PhysicsUofRAUI/Decorations/tlc555cp_christmas/tree.png

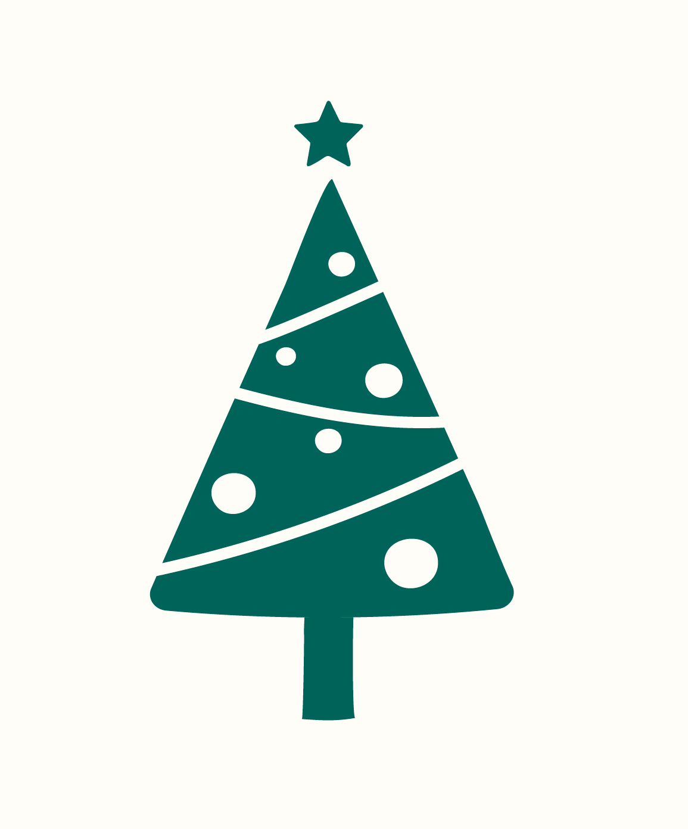
tlc555cp_christmas/tree.png
