PhysicsUofRAUI/Decorations/tlc555cp_easter/easter_egg_pic.jpg

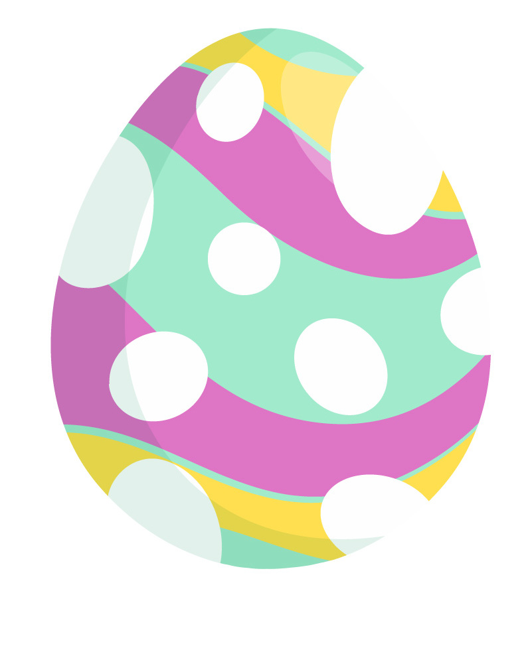
tlc555cp_easter/easter_egg_pic.jpg
