PhysicsUofRAUI/Decorations/tlc555cp_easter/tlc555cp_easter.kicad_pcb

## KiCad design tlc555cp_easter/tlc555cp_easter.kicad_pcb (2023-01-28)

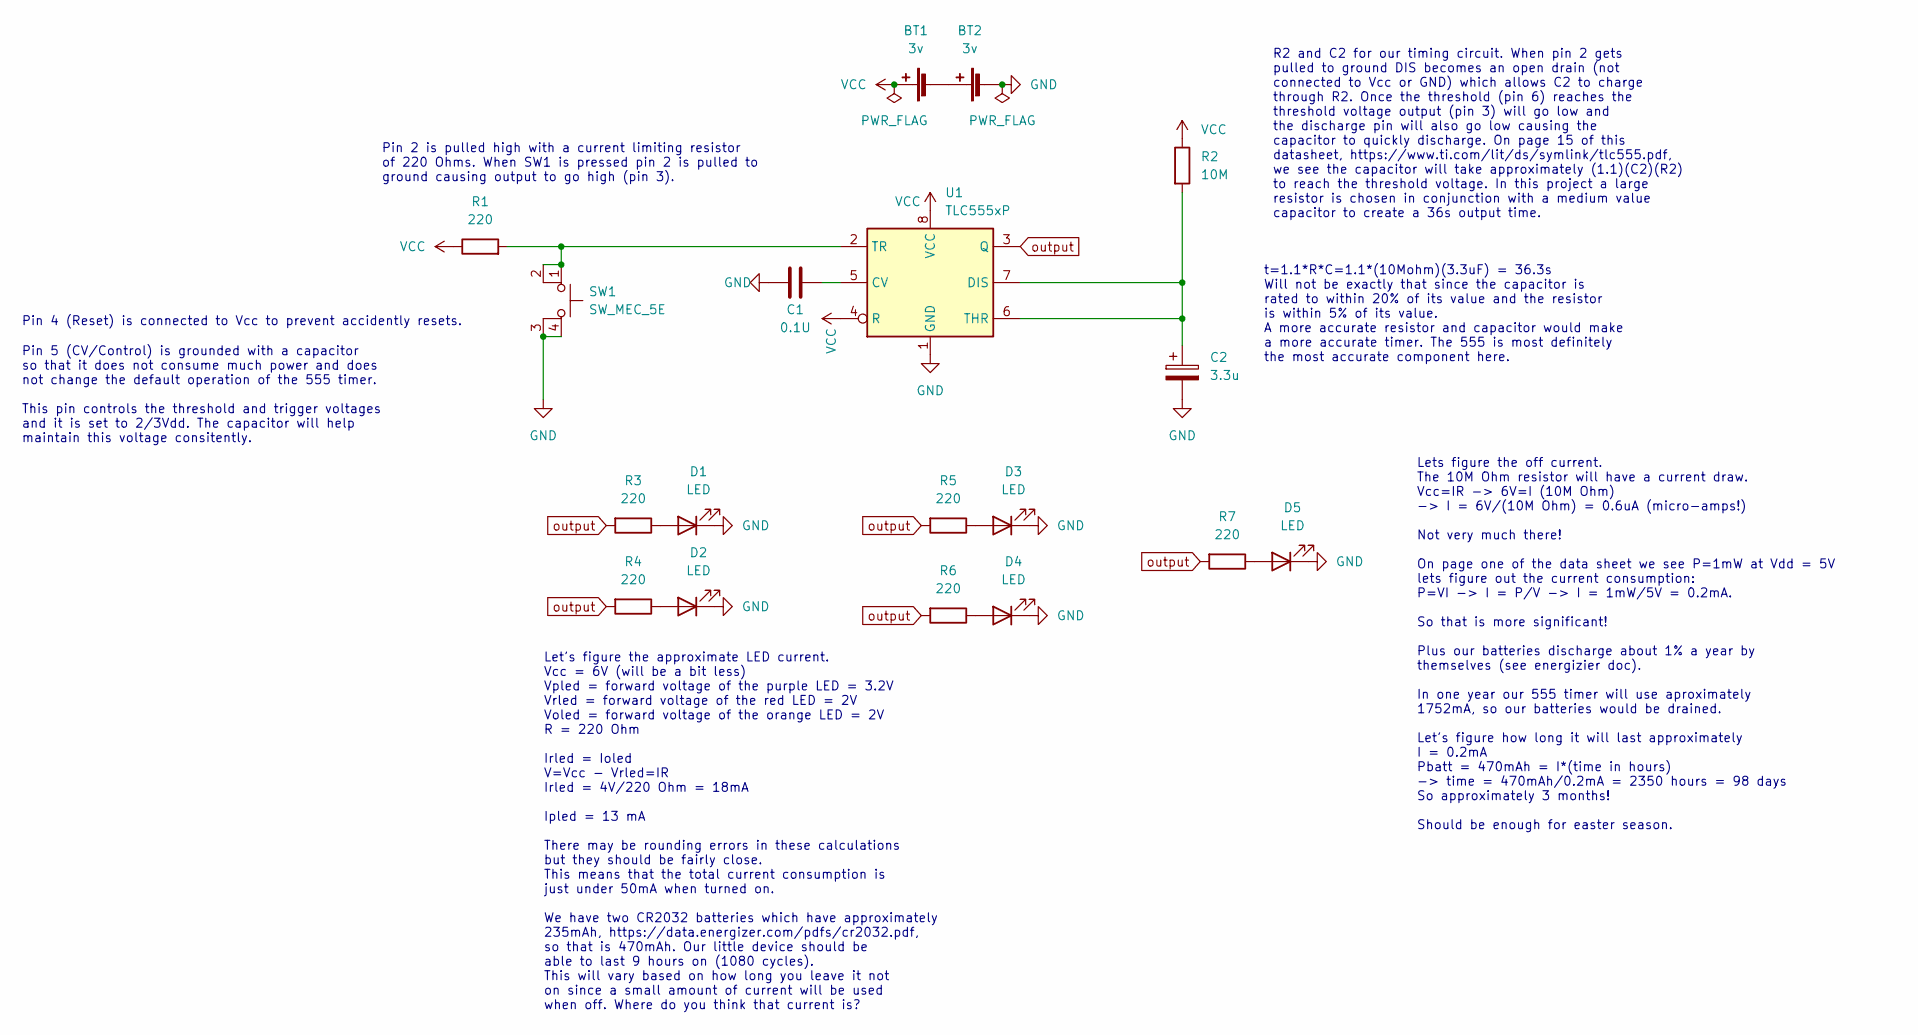
[picture p3: schematic tlc555cp_easter.kicad_sch]

Parts:
BT1, BT2: 3v; 1066
C1: 0.1U; CP_Radial_D5.0mm_P2.50mm
C2: 3.3u; CP_Radial_D5.0mm_P2.50mm
D1, D2, D3, D4, D5: LED; LED_D5.0mm
R1, R3, R4, R5, R6, R7: 220; R_Axial_DIN0204_L3.6mm_D1.6mm_P7.62mm_Horizontal
R2: 10M; R_Axial_DIN0204_L3.6mm_D1.6mm_P7.62mm_Horizontal
SW1: SW_MEC_5E; SW_PUSH-12mm_kody
U1: TLC555xP; DIP-8_W7.62mm

Connections:
GND: BT2.2 (-), C1.2, C2.2, D1.1 (K), D2.1 (K), D3.1 (K), D4.1 (K), D5.1 (K), SW1.3 (K), SW1.4 (A), U1.1 (GND)
unnamed: BT1.2 (-), BT2.1 (+)
unnamed: C2.1, R2.2, U1.6 (THR), U1.7 (DIS)
unnamed: D1.2 (A), R3.1
unnamed: D2.2 (A), R4.1
unnamed: D3.2 (A), R5.1
unnamed: D4.2 (A), R6.1
unnamed: D5.2 (A), R7.1
unnamed: R1.2, SW1.1, SW1.2, U1.2 (TR)
unnamed: C1.1, U1.5 (CV)
VCC: BT1.1 (+), R1.1, R2.1, U1.4 (R), U1.8 (VCC)
output: R3.2, R4.2, R5.2, R6.2, R7.2, U1.3 (Q)

Notes on the sheet:
Pin 4 (Reset) is connected to Vcc to prevent accidently resets.
t=1.1*R*C=1.1*(10Mohm)(3.3uF) = 36.3s Will not be exactly that since the capacitor is rated to within 20% of its value and the resistor is within 5% of its value. A more accurate resistor and capacitor would make a more accurate timer. The 555 is most definitely the most accurate component here.
Pin 2 is pulled high with a current limiting resistor of 220 Ohms. When SW1 is pressed pin 2 is pulled to ground causing output to go high (pin 3).
Pin 5 (CV/Control) is grounded with a capacitor so that it does not consume much power and does not change the default operation of the 555 timer. This pin controls the threshold and trigger voltages and it is set to 2/3Vdd. The capacitor will help maintain this voltage consitently.
Lets figure the off current. The 10M Ohm resistor will have a current draw. Vcc=IR -> 6V=I (10M Ohm) -> I = 6V/(10M Ohm) = 0.6uA (micro-amps!) Not very much there! On page one of the data sheet we see P=1mW at Vdd = 5V lets figure out the current consumption: P=VI -> I = P/V -> I = 1mW/5V = 0.2mA. 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
Let's figure the approximate LED current. Vcc = 6V (will be a bit less) Vpled = forward voltage of the purple LED = 3.2V Vrled = forward voltage of the red LED = 2V Voled = forward voltage of the orange LED = 2V R = 220 Ohm Irled = Ioled V=Vcc - Vrled=IR Irled = 4V/220 Ohm = 18mA Ipled = 13 mA Ther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
R2 and C2 for our timing circuit. When pin 2 gets pulled to ground DIS becomes an open drain (not connected to Vcc or GND) which allows C2 to charge through R2. Once the threshold (pin 6) reaches the threshold voltage output (pin 3) will go low and the discharge pin will also go low causing the cap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

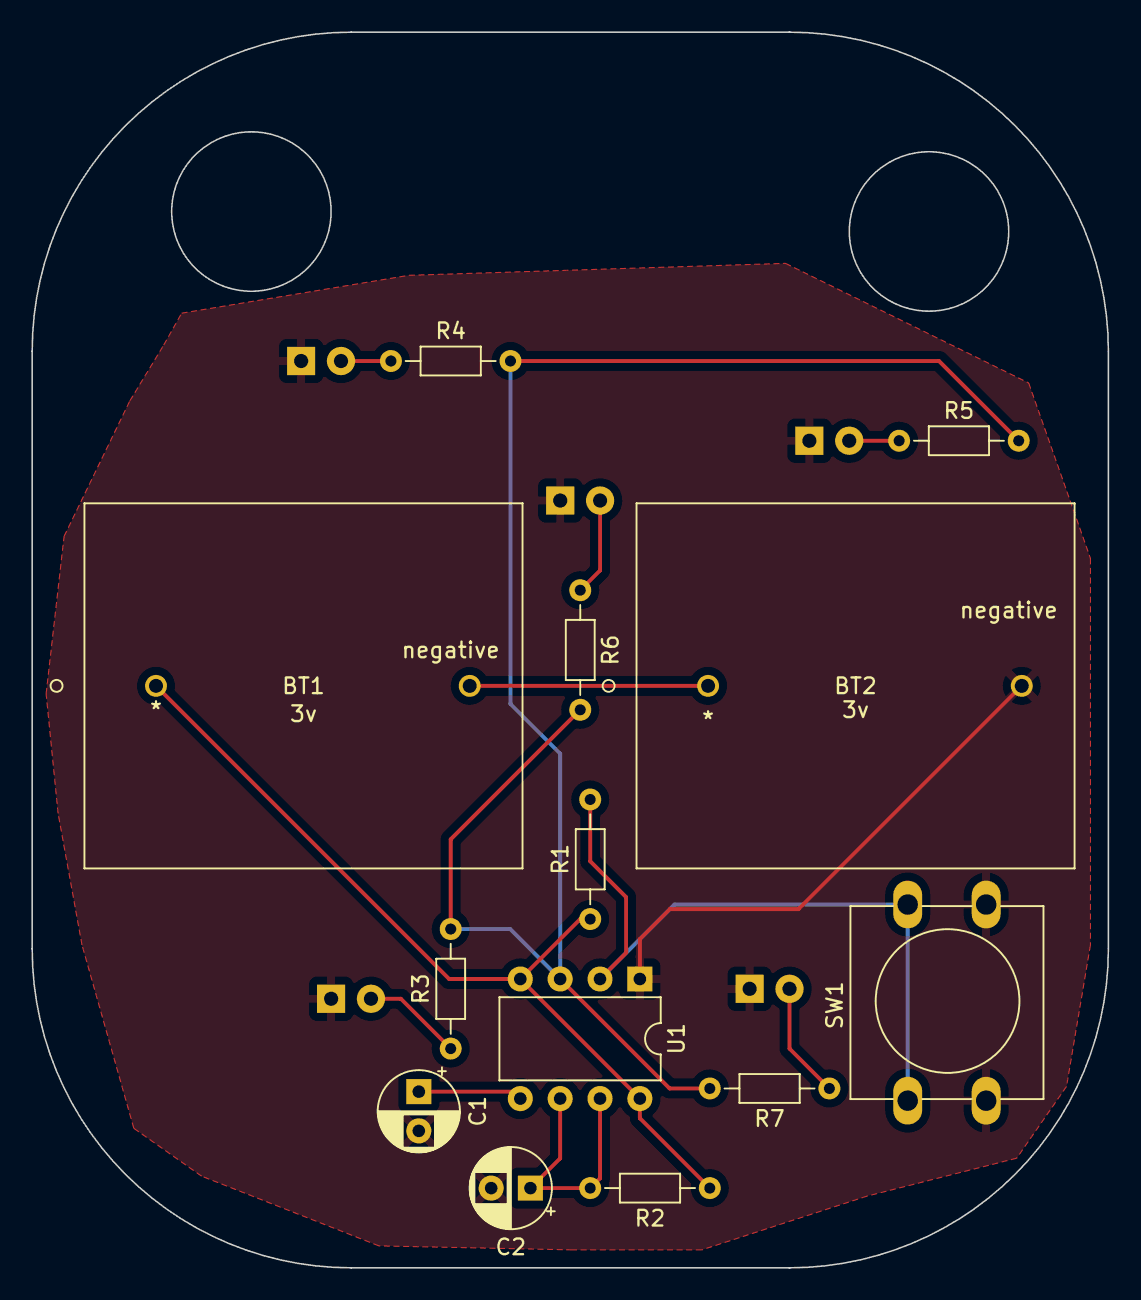
[picture p4: board tlc555cp_easter.kicad_pcb from above]

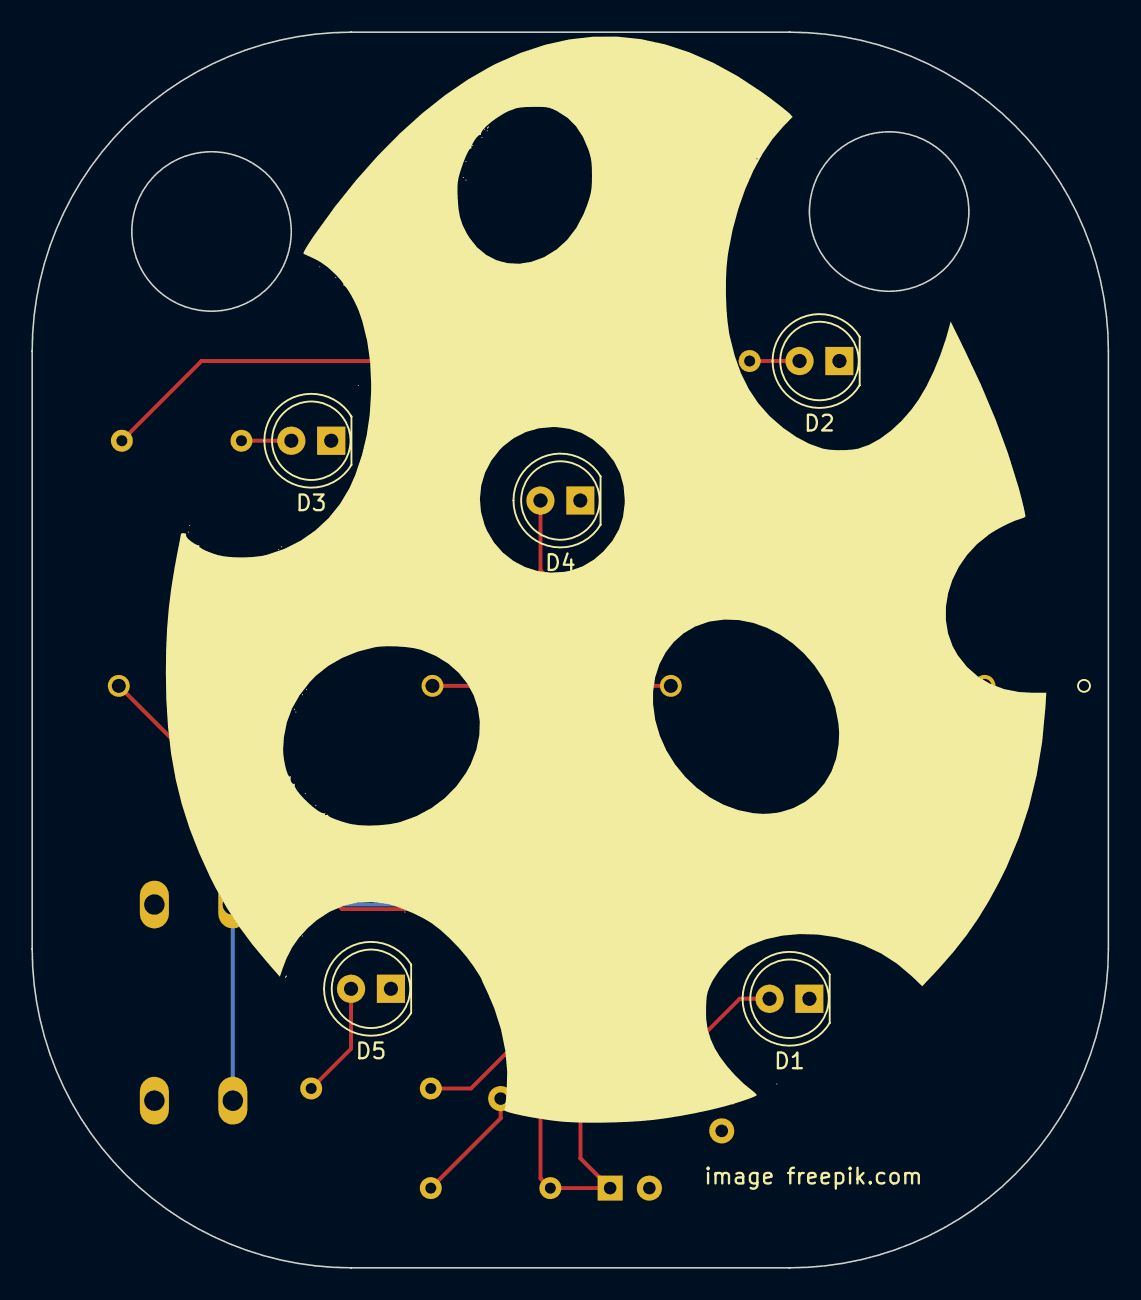
[picture p5: board tlc555cp_easter.kicad_pcb from below]

Board: 2 copper layers, 68.6 x 78.7 mm, 18 parts (5 on the bottom side), 12 nets.
