PhysicsUofRAUI/Decorations/tlc555cp_christmas/tlc555cp_christmas.kicad_pcb

## KiCad design tlc555cp_christmas/tlc555cp_christmas.kicad_pcb (2023-01-28)

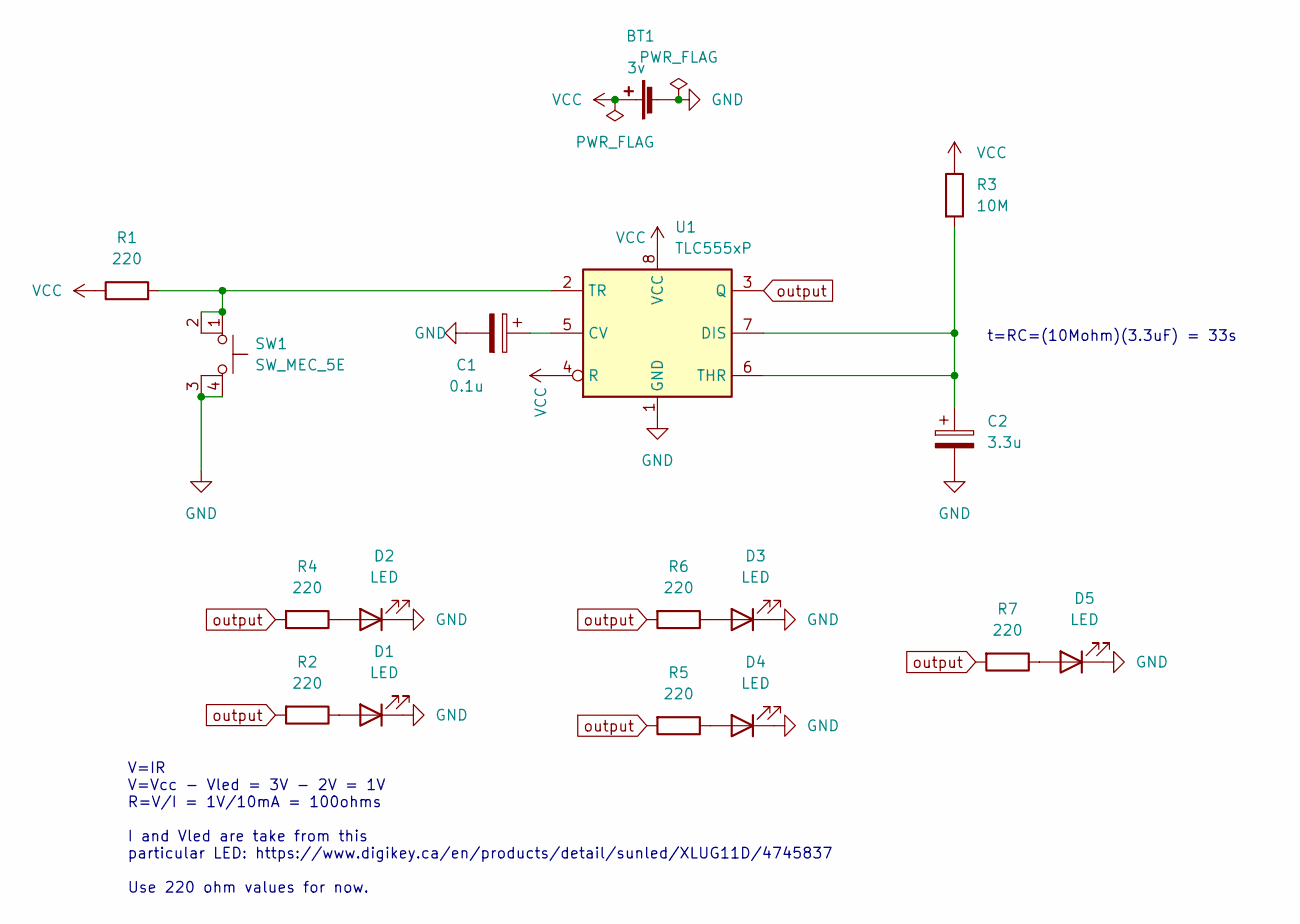
[picture p6: schematic tlc555cp_christmas.kicad_sch]

Parts:
BT1: 3v; 1066
C1: 0.1u; CP_Radial_D4.0mm_P2.00mm
C2: 3.3u; CP_Radial_D5.0mm_P2.50mm
D1, D2, D3, D4, D5: LED; LED_D5.0mm
R1, R2, R4, R5, R6, R7: 220; R_Axial_DIN0204_L3.6mm_D1.6mm_P5.08mm_Horizontal
R3: 10M; R_Axial_DIN0204_L3.6mm_D1.6mm_P5.08mm_Horizontal
SW1: SW_MEC_5E; SW_PUSH-12mm_kody
U1: TLC555xP; DIP-8_W7.62mm

Connections:
GND: BT1.2 (-), C1.2, C2.2, D1.1 (K), D2.1 (K), D3.1 (K), D4.1 (K), D5.1 (K), SW1.3 (K), SW1.4 (A), U1.1 (GND)
unnamed: C1.1, U1.5 (CV)
unnamed: C2.1, R3.2, U1.6 (THR), U1.7 (DIS)
unnamed: D1.2 (A), R2.1
unnamed: D2.2 (A), R4.1
unnamed: D3.2 (A), R6.1
unnamed: D4.2 (A), R5.1
unnamed: D5.2 (A), R7.1
unnamed: R1.2, SW1.1, SW1.2, U1.2 (TR)
VCC: BT1.1 (+), R1.1, R3.1, U1.4 (R), U1.8 (VCC)
output: R2.2, R4.2, R5.2, R6.2, R7.2, U1.3 (Q)

Notes on the sheet:
t=RC=(10Mohm)(3.3uF) = 33s
V=IR V=Vcc - Vled = 3V - 2V = 1V R=V/I = 1V/10mA = 100ohms I and Vled are take from this particular LED: https://www.digikey.ca/en/products/detail/sunled/XLUG11D/4745837 Use 220 ohm values for now.

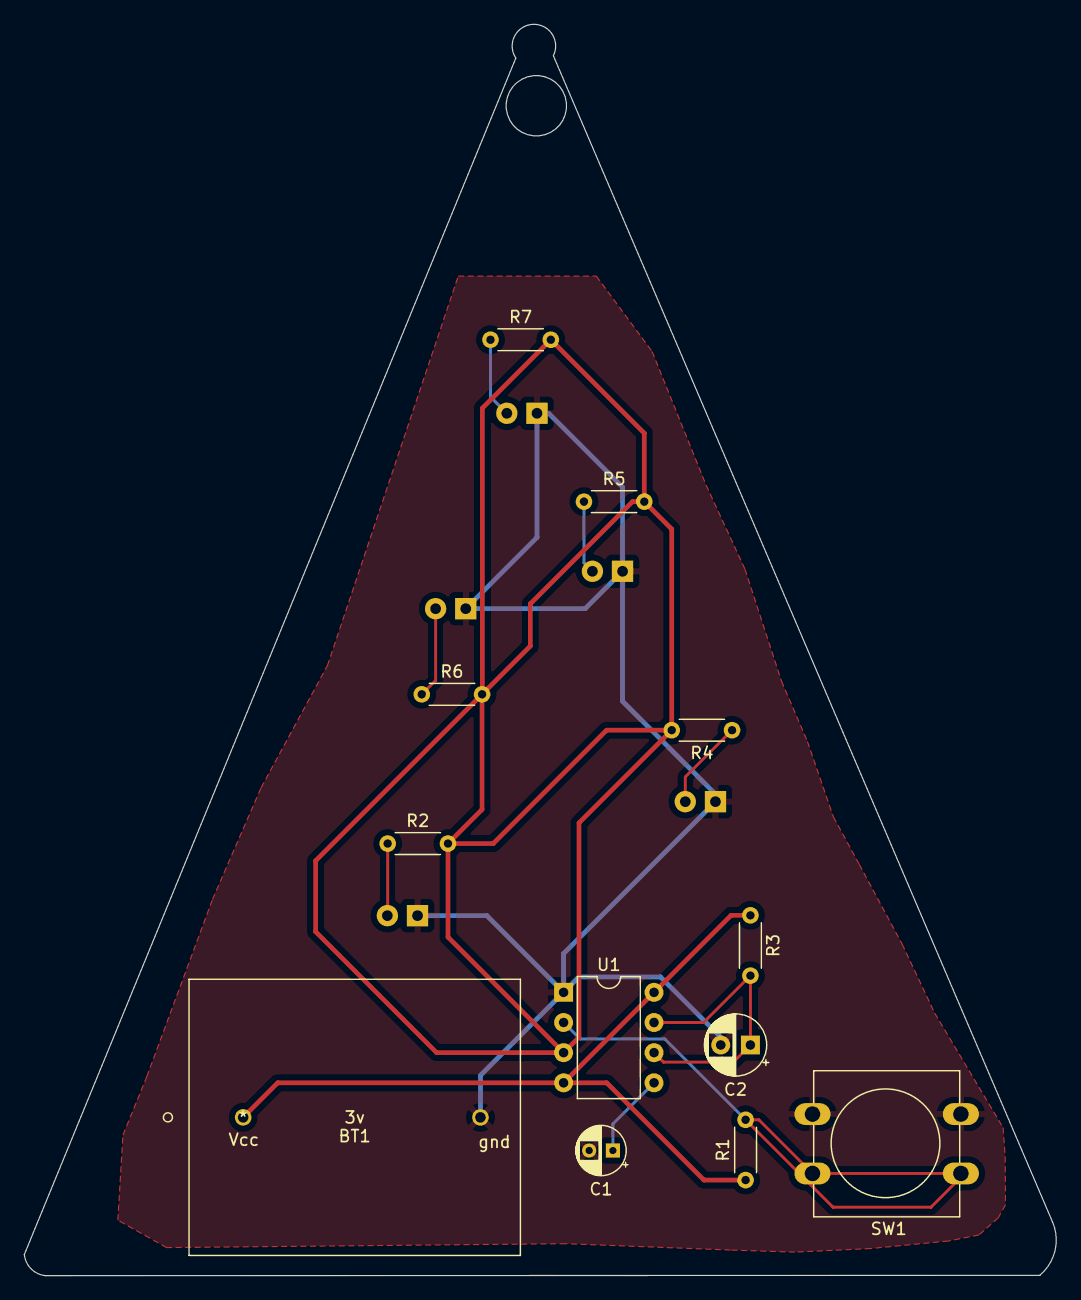
[picture p7: board tlc555cp_christmas.kicad_pcb from above]

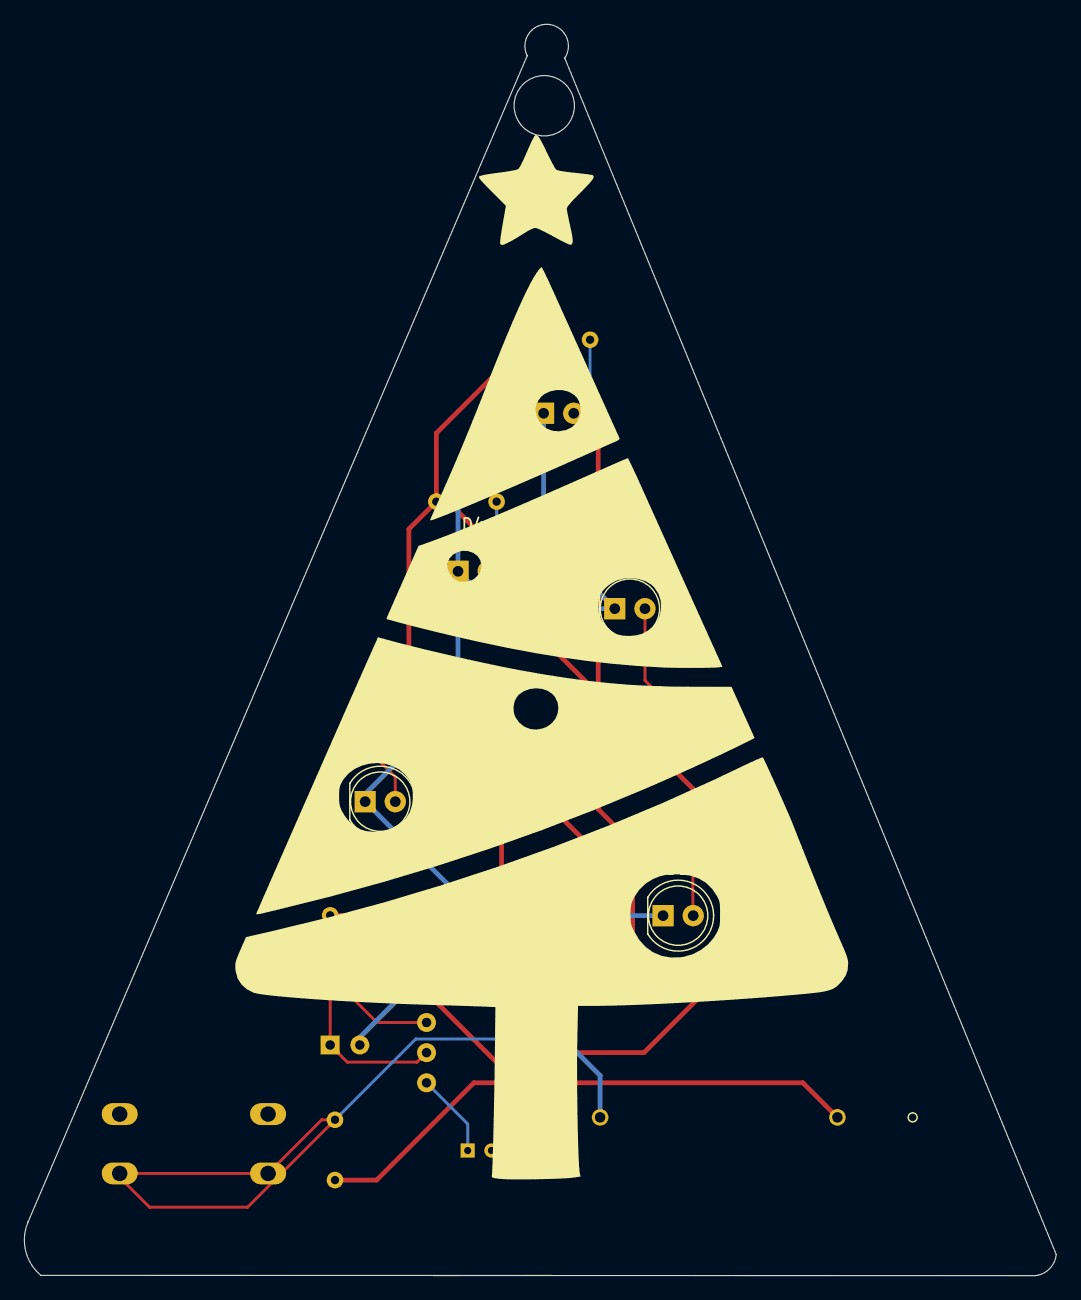
[picture p8: board tlc555cp_christmas.kicad_pcb from below]

Board: 2 copper layers, 86.9 x 105.4 mm, 17 parts (5 on the bottom side), 11 nets.
