PhysicsUofRAUI/Decorations/(threads)

Thread 1 (2023-01-20):

Switch Not wired Correctly

PhysicsUofRAUI, 2023-01-20:
The switch on the 555 projects is always grounded because I thought the wrong pins were connected together. Looking at the first page of the datasheet here, https://sten-eswitch-13110800-production.s3.amazonaws.com/system/asset/product_line/data_sheet/143/TL1100.pdf, it can easily be seen the pin numbering of which I need to change on the actual footprint.

Closed 2023-01-28.
