PhysicsUofRAUI/Decorations/(commit log)

2023-01-07 intial commit for tree decoration
    [tlc555cp_christmas.kicad_pcb, tlc555cp_christmas.kicad_sch]
2023-01-08 versior ordered on january 8 2023
    [tlc555cp_christmas.kicad_pcb, tlc555cp_christmas.kicad_sch]
2023-01-08 slight change on christmas pcb
    [tlc555cp_christmas.kicad_sch]
2023-01-09 add easter decoration
    [tlc555cp_easter.kicad_pcb, tlc555cp_easter.kicad_sch]
2023-01-28 Fix switch footprint pad assignment.
    [tlc555cp_christmas.kicad_pcb, tlc555cp_christmas.kicad_sch, tlc555cp_easter.kicad_pcb, tlc555cp_easter.kicad_sch]
